dronebo1/lipo-charger-breakout-board/README.md

# lipo-charger-breakout-board
Ever wanted to fully utilize every channel on your 8S/6S lipo charger? Use this board to use every channel at the same time, breaking out up to 8 channels, allowing you to charge 8 1S cells, 2 4S cells, or even one 4S cell with 2 2S cells. It also comes with basic safety features to ensure that you connect cells correctly, USBC PD, and a low voltage monitor to ensure you don't over drain your cells.
