dronebo1/lipo-charger-breakout-board/grantscreenshots/BEC_1.jpg

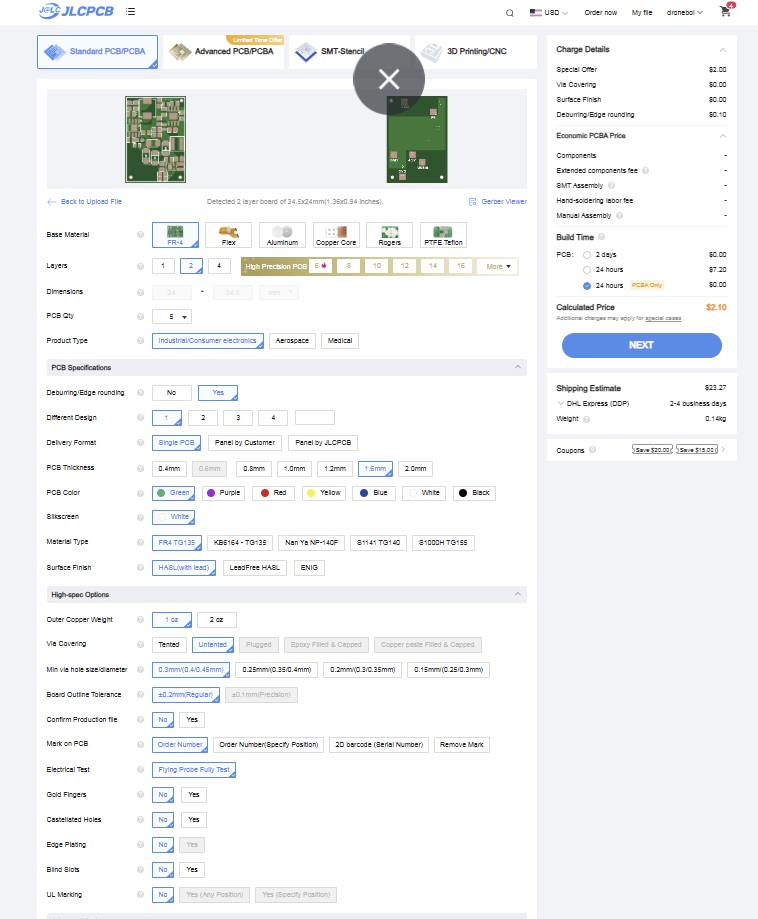
grantscreenshots/BEC_1.jpg
