dronebo1/lipo-charger-breakout-board/grantscreenshots/BEC_2.jpg

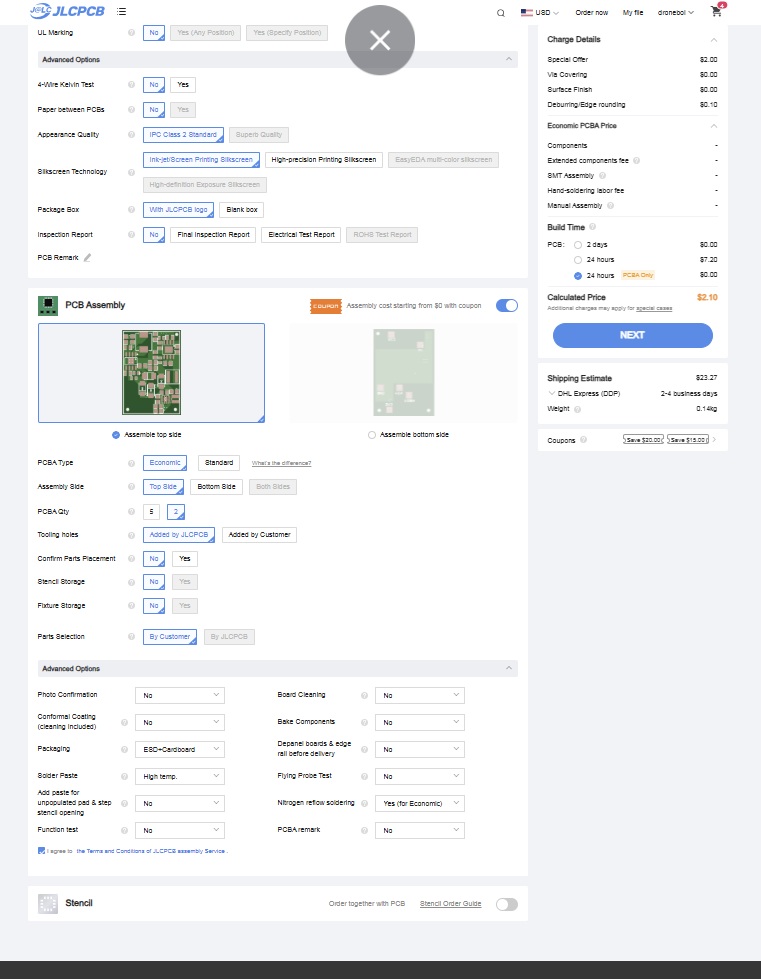
grantscreenshots/BEC_2.jpg
