dronebo1/lipo-charger-breakout-board/grantscreenshots/BEC_3.jpg

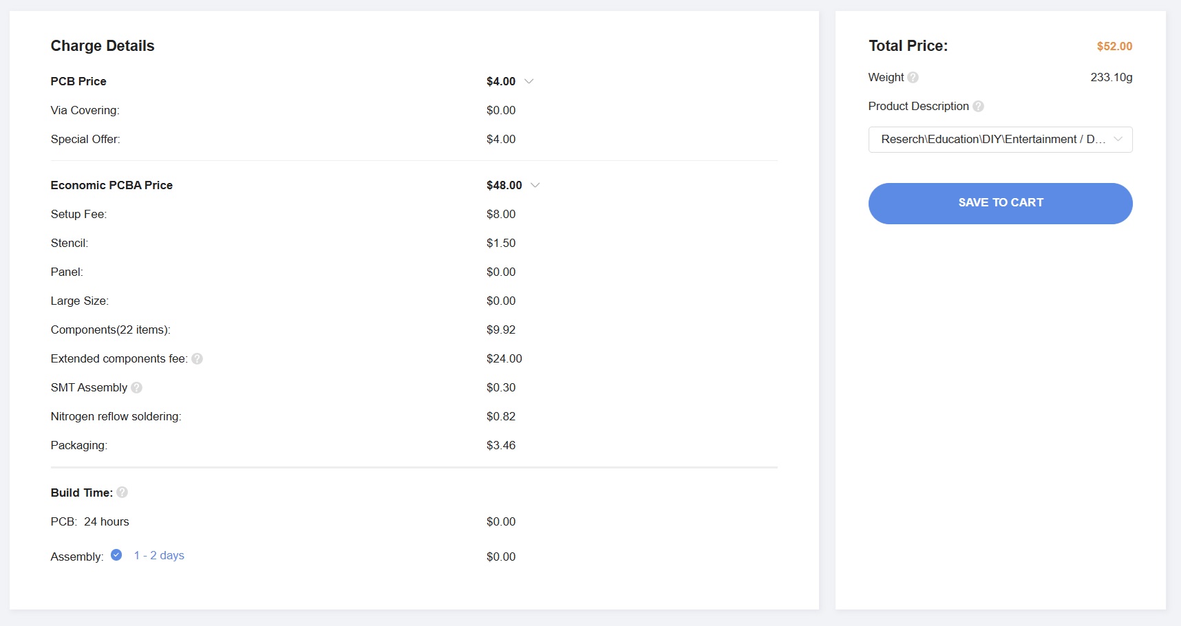
grantscreenshots/BEC_3.jpg
