dronebo1/lipo-charger-breakout-board/grantscreenshots/final_public.jpg

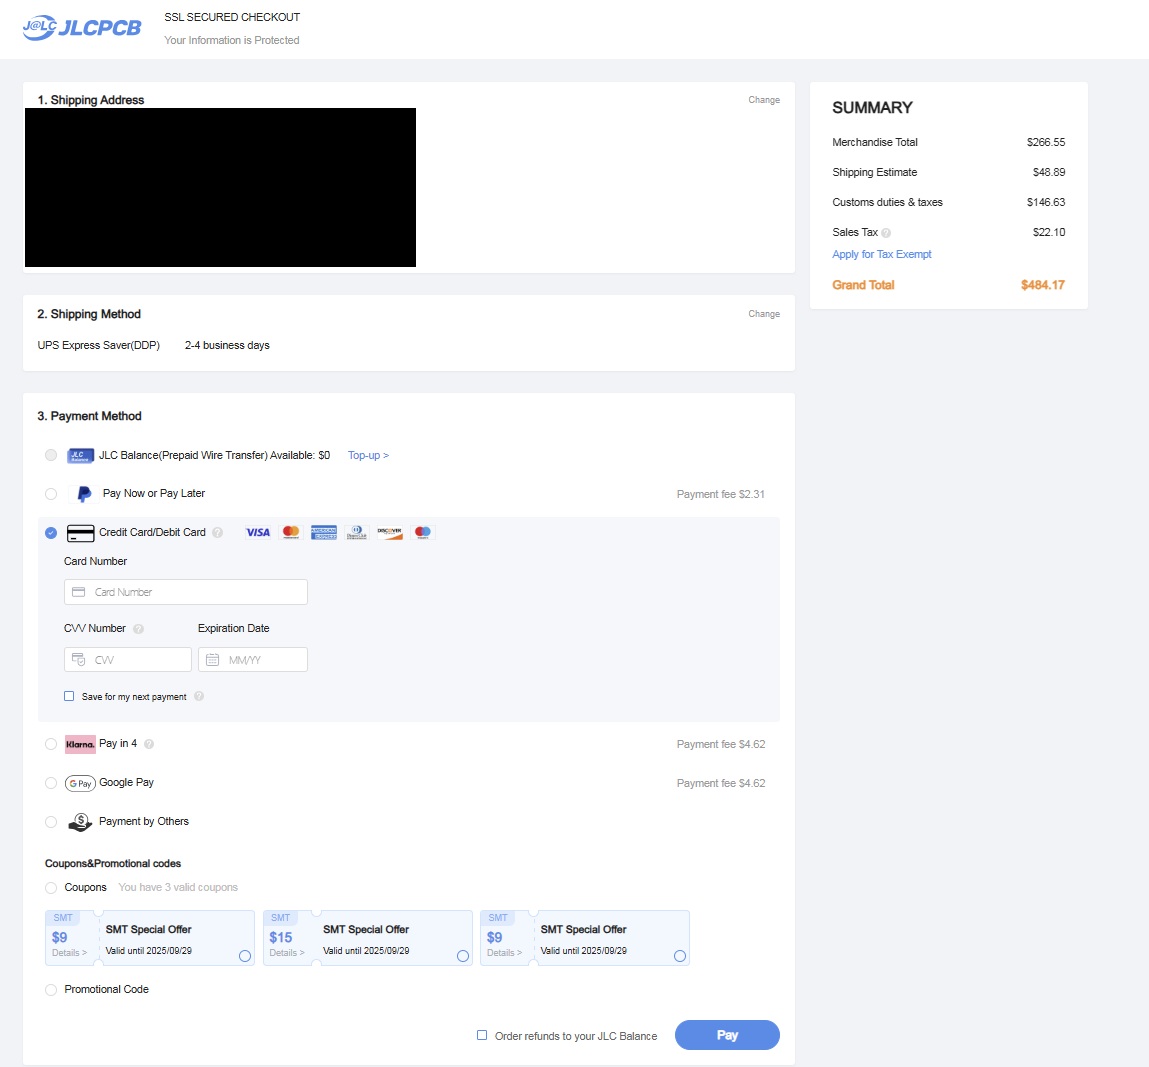
grantscreenshots/final_public.jpg
