dronebo1/lipo-charger-breakout-board/grantscreenshots/mainboard_1.jpg

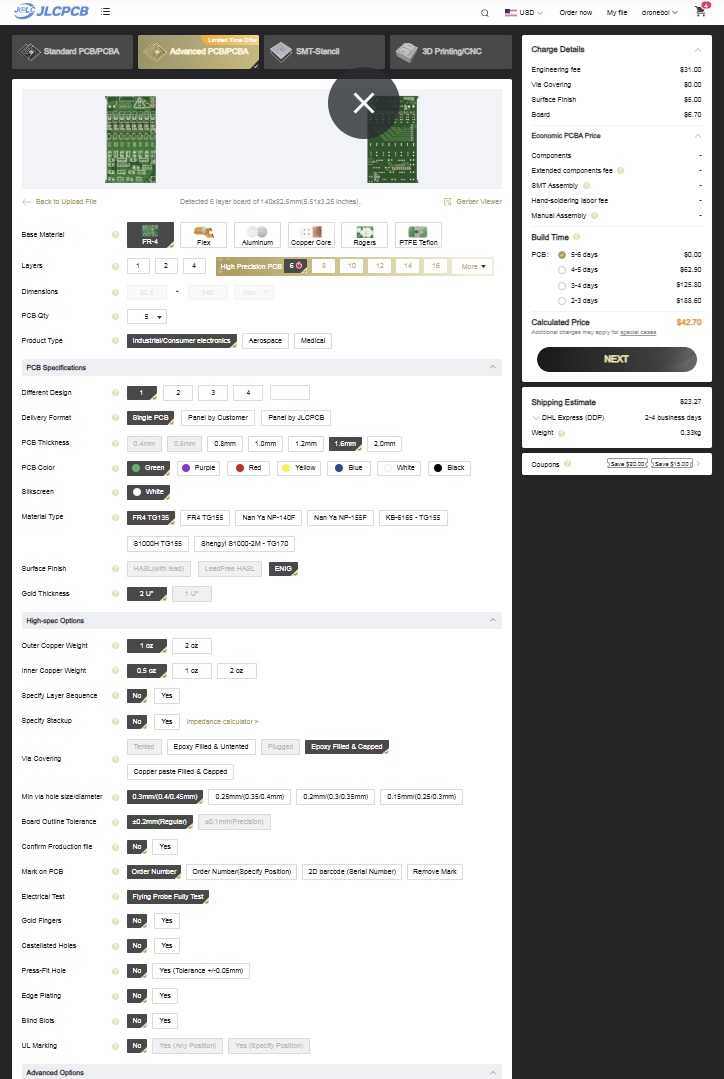
grantscreenshots/mainboard_1.jpg
