dronebo1/lipo-charger-breakout-board/grantscreenshots/mainboard_2.jpg

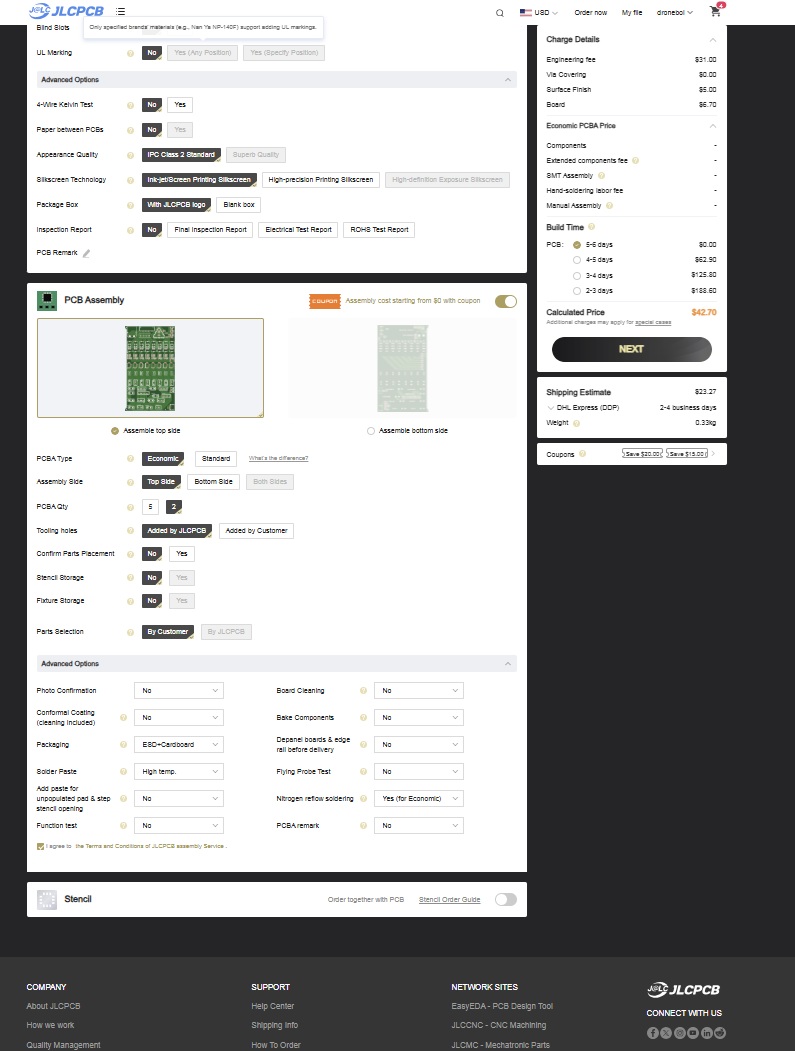
grantscreenshots/mainboard_2.jpg
