dronebo1/lipo-charger-breakout-board/grantscreenshots/overall.jpg

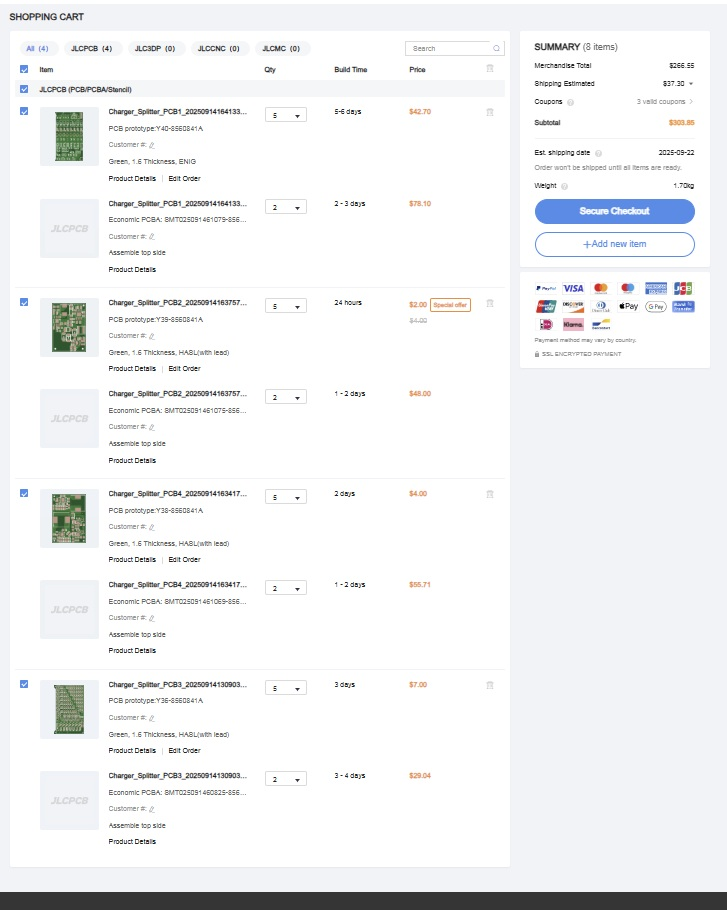
grantscreenshots/overall.jpg
