dronebo1/lipo-charger-breakout-board/grantscreenshots/protector_1.jpg

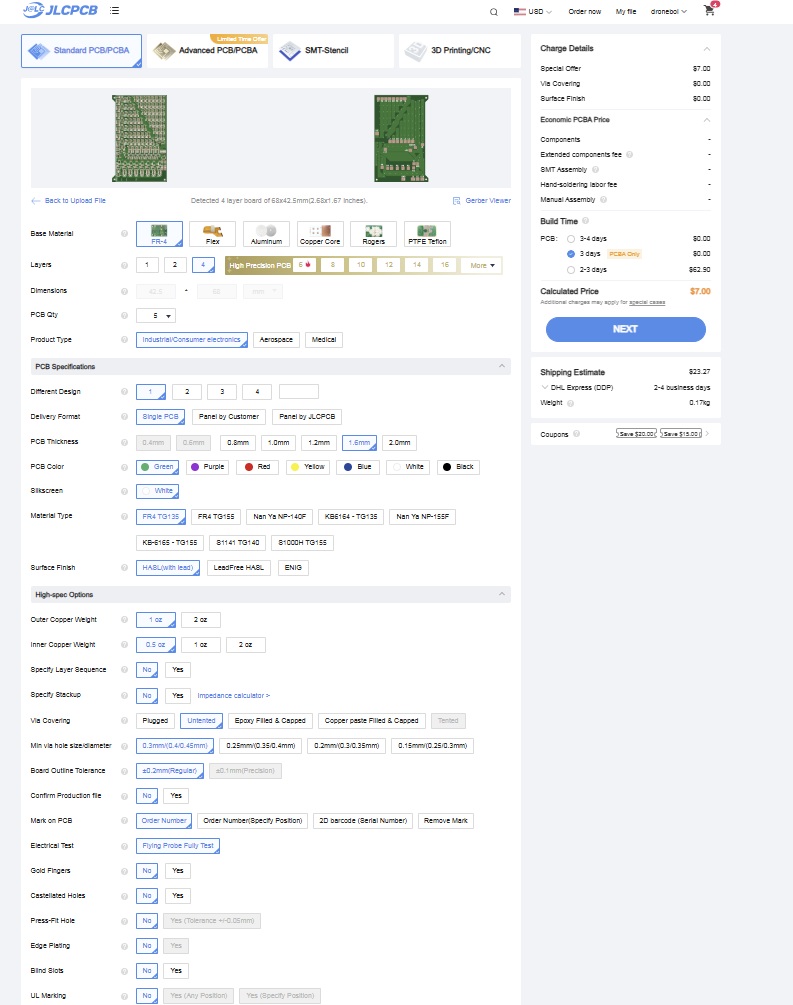
grantscreenshots/protector_1.jpg
