dronebo1/lipo-charger-breakout-board/grantscreenshots/protector_2.jpg

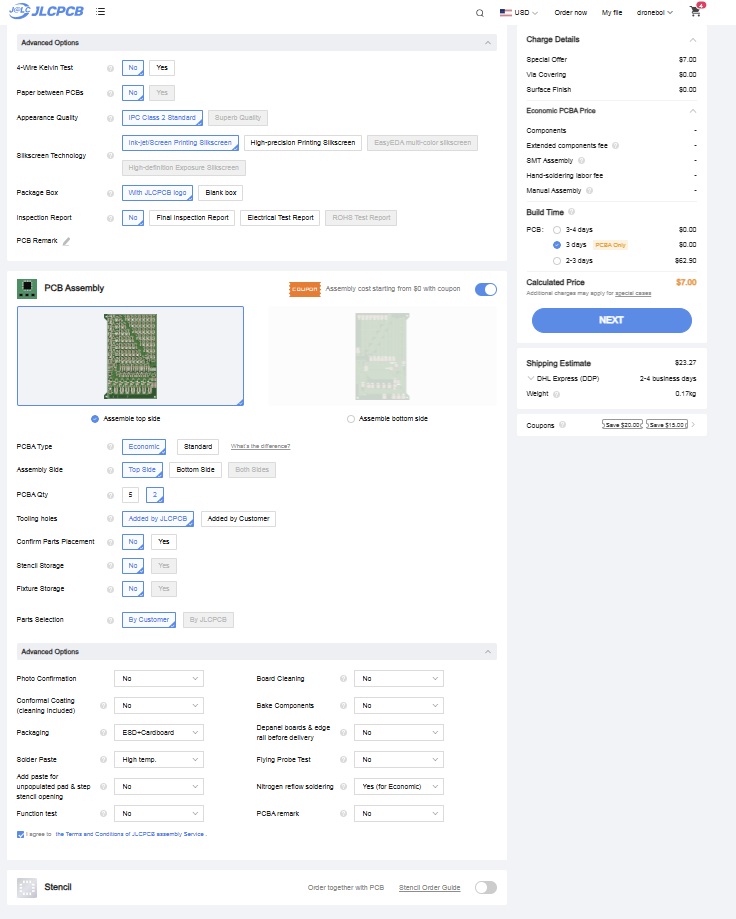
grantscreenshots/protector_2.jpg
