dronebo1/lipo-charger-breakout-board/productionfiles/MAINBOARD_BOM.xlsx

No. | Quantity | Comment | Designator | Footprint | Value | Manufacturer Part | Manufacturer | Supplier Part | Supplier
1 | 8 | PH2.0-2P-LT | 1S1,1S2,1S3,1S4,1S5,1S6,1S7,1S8 | CONN-SMD_PH2.0-1X2PW |  | PH2.0-2P-LT | CAX(创都) | C722761 | LCSC
2 | 12 | XT30UPB-M | 2S1,2S2,2S3,2S4,3S1,3S2,4S1,4S2,6S1,(3S+)2S1,(3S+)2S2,(3S+)4S1 | CONN-TH_XT30UPB-M |  | XT30UPB-M | AMASS(艾迈斯) | C428721 | LCSC
3 | 6 | XH-3A | 2S1B,2S2B,2S3B,2S4B,(3S+)2S1B,(3S+)2S2B | CONN-TH_XH-3A |  | XH-3A | HCTL(华灿天禄) | C2908601 | LCSC
4 | 2 | XH-4A | 3S1B,3S2B1 | CONN-TH_XH2.50-4P |  | XH-4A | HCTL(华灿天禄) | C2908602 | LCSC
5 | 3 | XH-5A | 4S1B,4S2B,(3S+)4S1B | CONN-TH_5P-P2.50_XH-5A |  | XH-5A | HCTL(华灿天禄) | C2908603 | LCSC
6 | 1 | XH-7A | 6S1B | CONN-TH_7P-P2.50_HCTL_XH-7A |  | XH-7A | HCTL(华灿天禄) | C2908605 | LCSC
7 | 8 | NCD0805R1 | CELL1,CELL2,CELL3,CELL4,CELL5,CELL6,CELL7,CELL8 | LED0805-R-RD |  | NCD0805R1 | 国星光电 | C84256 | LCSC
8 | 3 | KT-1206W | CELL,LOWBATT,SWITCH | LED1206-R-RD_WHITE |  | KT-1206W | KENTO | C71796 | LCSC
9 | 12 | AGM6014AP | CELLLEDQ1,CELLLEDQ2,CELLLEDQ3,CELLLEDQ4,CELLLEDQ5,CELLLEDQ6,CELLLEDQ7,CELLLEDQ8,ERRORLEDARRQ1,ERRORLEDQ1,ERRORLEDQ2,ERRORLEDQ3 | PDFN-8_L3.1-W3.0-P0.65-LS3.3-BL |  | AGM6014AP | AGM-Semi(芯控源) | C6719405 | LCSC
10 | 1 | 68Ω | CELLLEDR1 | R2512 | 68Ω | 25121WF680JT4E | UNI-ROYAL(厚声) | C50371 | LCSC
11 | 1 | XH-9AW | CN9 | CONN-TH_9P-P2.50_XH-9AW |  | XH-9AW | BOOMELE(博穆精密) | C44437 | LCSC
12 | 1 | XT60PW-M | CN10 | CONN-TH_XT60PW-M |  | XT60PW-M | AMASS(艾迈斯) | C98732 | LCSC
13 | 12 | XL-2012UPC | ERRORLEDARR1,ERRORLEDARR2,ERRORLEDARR3,ERRORLEDARR4,ERRORLEDARR5,ERRORLEDARR6,ERRORLEDARR7,ERRORLEDARR8,ERRORLEDARR9,ERRORLEDARR10,ERRORLEDARR11,ERRORLEDARR12 | LED0805-RD_PINK |  | XL-2012UPC | XINGLIGHT(成兴光) | C965821 | LCSC
14 | 1 | 30Ω | ERRORLEDARRR1 | R2512 | 30Ω | 25121WF300JT4E | UNI-ROYAL(厚声) | C620878 | LCSC
15 | 1 | 20Ω | ERRORLEDR3 | R1210 | 20Ω | 1210W2F200JT5E | UNI-ROYAL(厚声) | C620667 | LCSC
16 | 1 | XH-7A | P2 | CONN-TH_7P_XH-7A |  | XH-7A | BOOMELE(博穆精密) | C10384 | LCSC
17 | 8 | SS-22F07-G100 | SW1,SW2,SW3,SW4,SW5,SW6,SW7,SW8 | SW-TH_6P-L16.5-W7.5-P4.0-LS2.6-TL |  | SS-22F07-G100 | G-Switch(品赞) | C5446810 | LCSC
18 | 8 | NCD0805Y1 | SW1LED1,SW2LED1,SW3LED1,SW4LED1,SW5LED1,SW6LED1,SW7LED1,SW8LED1 | LED0805-R-RD |  | NCD0805Y1 | 国星光电 | C84261 | LCSC
19 | 8 | 3kΩ | SW1R1,SW2R1,SW3R1,SW4R1,SW5R1,SW6R1,SW7R1,SW8R1 | R0805 | 3kΩ | 0805W8F3001T5E | UNI-ROYAL(厚声) | C17661 | LCSC
20 | 8 | 68Ω | SW1R2,SW2R2,SW3R2,SW4R2,SW5R2,SW6R2,SW7R2,SW8R2 | R0805 | 68Ω | RC0805FR-0768RL | YAGEO(国巨) | C137498 | LCSC
21 | 1 | KH-TYPE-C-6P | USB-IN | TYPE-C-SMD_TYPE-C-31-M-16 |  | KH-TYPE-C-6P | kinghelm(金航标) | C709355 | LCSC
22 | 1 | TYPE-C-31-M-12 | USB-OUT | USB-C_SMD-TYPE-C-31-M-12 |  | TYPE-C-31-M-12 | 韩国韩荣 | C165948 | LCSC
