dronebo1/lipo-charger-breakout-board/productionfiles/USBPD_BOM.xlsx

No. | Quantity | Comment | Designator | Footprint | Value | Manufacturer Part | Manufacturer | Supplier Part | Supplier
1 | 2 | 100nF | BUCKC1,PDC1 | C0805 | 100nF | CC0805KRX7R9BB104 | YAGEO(国巨) | C49678 | LCSC
2 | 13 | 10uF | BUCKC2,BUCKC3,BUCKC4,BUCKC5,BUCKC6,PDC3,PDC4,PDC5,PDC6,PDC7,PDC8,PDC9,PDC12 | C0805 | 10uF | GRM21BR61H106KE43L | muRata(村田) | C440198 | LCSC
3 | 1 | RSX501L-20TE25 | BUCKD1 | SMA_L4.5-W2.6-LS5.0-RD |  | RSX501L-20TE25 | ROHM(罗姆) | C329921 | LCSC
4 | 1 | 15uH | BUCKL1 | IND-SMD_L13.7-W12.6_MS1360 | 15uH | FCH1365-150M | FC(方成) | C20415554 | LCSC
5 | 1 | 270kΩ | BUCKR1 | R0805 | 270kΩ | 0805W8F2703T5E | UNI-ROYAL(厚声) | C17589 | LCSC
6 | 2 | 13kΩ | BUCKR2,BUCKR6 | R0805 | 13kΩ | 0805W8F1302T5E | UNI-ROYAL(厚声) | C17455 | LCSC
7 | 1 | 200kΩ | BUCKR3 | R0805 | 200kΩ | 0805W8F2003T5E | UNI-ROYAL(厚声) | C17539 | LCSC
8 | 1 | 75kΩ | BUCKR4 | R0603 | 75kΩ | 0603WAF7502T5E | UNI-ROYAL(厚声) | C23242 | LCSC
9 | 2 | 3kΩ | BUCKR5,BUCKR7 | R0805 | 3kΩ | 0805W8F3001T5E | UNI-ROYAL(厚声) | C17661 | LCSC
10 | 1 | 10nF | C22 | C0805 | 10nF | CL21B103KBANNNC | SAMSUNG(三星) | C1710 | LCSC
11 | 2 | 47uF | C23,C24 | C0805 | 47uF | CL21A476MQYNNNE | SAMSUNG(三星) | C16780 | LCSC
12 | 2 | SP40P18NJ | HIGHQ1,LOWQ1 | DFN-8_L3.0-W3.0-P0.65-BL-EP_PE5G6EA |  | SP40P18NJ | Siliup(矽普) | C41355197 | LCSC
13 | 2 | AGM6014AP | HIGHQ2,LOWQ2 | PDFN-8_L3.1-W3.0-P0.65-LS3.3-BL |  | AGM6014AP | AGM-Semi(芯控源) | C6719405 | LCSC
14 | 2 | 2kΩ | HIGHR1,LOWR1 | R0805 | 2kΩ | 0805W8F2001T5E | UNI-ROYAL(厚声) | C17604 | LCSC
15 | 4 | 1kΩ | HIGHR2,HIGHR3,LOWR2,LOWR3 | R0805 | 1kΩ | 0805W8F1001T5E | UNI-ROYAL(厚声) | C17513 | LCSC
16 | 2 | EG27517 | HIGHU1,LOWU1 | SOT-23-5_L2.9-W1.6-P0.95-LS2.8-BR |  | EG27517 | EG(屹晶微) | C2987449 | LCSC
17 | 1 | AP64352SP-13 | PDBUCK1 | SO-8_L4.9-W3.9-P1.27-LS6.0-BL-EP |  | AP64352SP-13 | DIODES(美台) | C2071665 | LCSC
18 | 1 | 220uF | PDC2 | C1206 | 220uF | GRM31CR60J227ME11L | muRata(村田) | C412252 | LCSC
19 | 1 | 33uH | PDL1 | IND-SMD_L13.5-W12.5 | 33uH | TMPC1265HP-330MG-D | TAI-TECH(台庆) | C2880059 | LCSC
20 | 1 | 10kΩ | PDR1 | R0805 | 10kΩ | 0805W8F1002T5E | UNI-ROYAL(厚声) | C17414 | LCSC
21 | 2 | 2Ω | R1,R2 | R0603 | 2Ω | 0603WAF200KT5E | UNI-ROYAL(厚声) | C22977 | LCSC
22 | 1 | XPM52CDP65 | USBPDREG1 | QFN-16_L4.0-W4.0-P0.65-TL-EP2.3 |  | XPM52CDP65 | FM(富满) | C42460907 | LCSC
