dronebo1/lipo-charger-breakout-board/productionfiles/BEC_BOM.xlsx

No. | Quantity | Comment | Designator | Footprint | Value | Manufacturer Part | Manufacturer | Supplier Part | Supplier
1 | 1 | TPS63001DRCR | 3V3BUCKBOOST1 | VSON-10_L3.0-W3.0-P0.50-TL-EP_TPS62410DRCR |  | TPS63001DRCR | TI(德州仪器) | C28060 | LCSC
2 | 3 | 10uF | 3V3C1,3V3C3,3V3C4 | C0805 | 10uF | CL21A106KAYNNNE | SAMSUNG(三星) | C15850 | LCSC
3 | 2 | 100nF | 3V3C2,5VC1 | C0805 | 100nF | CC0805KRX7R9BB104 | YAGEO(国巨) | C49678 | LCSC
4 | 1 | 2.2uH | 3V3L1 | IND-SMD_L3.0-W3.0_NR3010 | 2.2uH | NR3015T2R2M | TAIYO YUDEN(太诱) | C86423 | LCSC
5 | 1 | 100Ω | 3V3R1 | R0805 | 100Ω | 0805W8F1000T5E | UNI-ROYAL(厚声) | C17408 | LCSC
6 | 4 | 22uF | 5VBC1,5VBC5,5VC3,5VC4 | C0805 | 22uF | CL21A226MAQNNNE | SAMSUNG(三星) | C45783 | LCSC
7 | 1 | 1nF | 5VBC2 | C0805 | 1nF | CL21B102KBCNNNC | SAMSUNG(三星) | C46653 | LCSC
8 | 1 | 100uF | 5VBC4 | CAP-SMD_L3.5-W2.8-R-RD | 100uF | CA45A-B-10V-100UF-K | CEC(振华新云) | C2976906 | LCSC
9 | 3 | RSX501L-20TE25 | 5VBD1,5VD1,USB-IND1 | SMA_L4.5-W2.6-LS5.0-RD |  | RSX501L-20TE25 | ROHM(罗姆) | C329921 | LCSC
10 | 1 | 3.3uH | 5VBL1 | IND-SMD_L7.0-W6.6 | 3.3uH | FXL0630-3R3-M | cjiang(长江微电) | C167219 | LCSC
11 | 1 | FP6276BXR-G1 | 5VBOOST1 | SOP-8_L4.9-W3.9-P1.27-LS6.0-BL-EP |  | FP6276BXR-G1 | Advanced Analog Technology(类比) | C82652 | LCSC
12 | 2 | 10kΩ | 5VBR1,5VBR3 | R0805 | 10kΩ | 0805W8F1002T5E | UNI-ROYAL(厚声) | C17414 | LCSC
13 | 1 | 75kΩ | 5VBR2 | R0603 | 75kΩ | 0603WAF7502T5E | UNI-ROYAL(厚声) | C23242 | LCSC
14 | 2 | 39kΩ | 5VBR4,5VR2 | R0603 | 39kΩ | 0603WAF3902T5E | UNI-ROYAL(厚声) | C23153 | LCSC
15 | 1 | AP64352SP-13 | 5VBUCK1 | SO-8_L4.9-W3.9-P1.27-LS6.0-BL-EP |  | AP64352SP-13 | DIODES(美台) | C2071665 | LCSC
16 | 1 | 10nF | 5VC2 | C0805 | 10nF | CL21B103KBANNNC | SAMSUNG(三星) | C1710 | LCSC
17 | 1 | 10uF | 5VCx | C0805 | 10uF | GRM21BR61H106KE43L | muRata(村田) | C440198 | LCSC
18 | 1 | 5.6uH | 5VL1 | IND-SMD_L5.5-W5.3 | 5.6uH | FEXL0550A-5R6M | cjiang(长江微电) | C5378514 | LCSC
19 | 1 | 150kΩ | 5VR1 | R0805 | 150kΩ | 0805W8F1503T5E | UNI-ROYAL(厚声) | C17470 | LCSC
20 | 1 | 200kΩ | 5VR3 | R0805 | 200kΩ | 0805W8F2003T5E | UNI-ROYAL(厚声) | C17539 | LCSC
21 | 1 | 120kΩ | 5VR4 | R0603 | 120kΩ | 0603WAF1203T5E | UNI-ROYAL(厚声) | C25808 | LCSC
22 | 1 | 20kΩ | 5VR5 | R0805 | 20kΩ | 0805W8F2002T5E | UNI-ROYAL(厚声) | C4328 | LCSC
