dronebo1/lipo-charger-breakout-board/productionfiles/LogicBOARD_BOM.xlsx

No. | Quantity | Comment | Designator | Footprint | Value | Manufacturer Part | Manufacturer | Supplier Part | Supplier
1 | 3 | 47uF | C1,C2,C3 | C0805 | 47uF | CL21A476MQYNNNE | SAMSUNG(三星) | C16780 | LCSC
2 | 8 | MM1Z3V3 | D22,D36,D38,D40,D42,D44,D46,D48 | SOD-123_L2.7-W1.6-LS3.7-RD |  | MM1Z3V3 | 宏嘉诚 | C22379456 | LCSC
3 | 18 | SD103AWS | D23,D24,D25,D26,D27,D28,D29,D30,D37,D39,D41,D43,D45,D47,D49,D50,D51,D52 | SOD-323_L1.7-W1.3-LS2.6-RD-1 |  | SD103AWS | 宏迦橙 | C7420360 | LCSC
4 | 72 | MMBT4401 | Q164,Q165,Q166,Q167,Q168,Q169,Q170,Q171,Q172,Q173,Q174,Q175,Q176,Q177,Q178,Q179,Q180,Q181,Q182,Q183,Q184,Q185,Q186,Q187,Q188,Q189,Q190,Q191,Q192,Q193,Q194,Q195,Q196,Q197,Q198,Q199,Q200,Q201,Q202,Q203,Q204,Q205,Q206,Q207,Q208,Q209,Q210,Q211,Q212,Q213,Q214,Q215,Q216,Q217,Q218,Q219,Q220,Q221,Q222,Q223,Q224,Q225,Q226,Q227,Q228,Q229,Q230,Q231,Q232,Q233,Q234,Q235 | SOT-23-3_L2.9-W1.3-P1.90-LS2.4-BR |  | MMBT4401 | R+O(宏嘉诚) | C7420355 | LCSC
5 | 24 | MMBT4403 | Q237,Q238,Q239,Q240,Q241,Q242,Q243,Q244,Q245,Q246,Q247,Q248,Q249,Q250,Q251,Q252,Q253,Q254,Q255,Q256,Q257,Q258,Q259,Q260 | SOT-23-3_L2.9-W1.3-P0.95-LS2.4-BR |  | MMBT4403 | R+O(宏嘉诚) | C20069140 | LCSC
6 | 54 | 22kΩ | R81,R82,R83,R87,R88,R89,R90,R91,R92,R93,R94,R95,R96,R97,R98,R99,R100,R101,R102,R103,R104,R105,R106,R107,R108,R109,R110,R111,R112,R113,R114,R115,R116,R117,R118,R119,R120,R121,R122,R123,R124,R125,R126,R127,R128,R129,R130,R131,R132,R190,R217,R219,R222,R223 | R0603 | 22kΩ | 0603WAF2202T5E | UNI-ROYAL(厚声) | C31850 | LCSC
7 | 24 | 3kΩ | R171,R172,R174,R177,R180,R183,R186,R189,R193,R194,R196,R199,R202,R205,R208,R211,R267,R268,R269,R270,R271,R272,R273,R274 | R0603 | 3kΩ | 0603WAF3001T5E | UNI-ROYAL(厚声) | C4211 | LCSC
8 | 2 | 6.2kΩ | R175,R212 | R0603 | 6.2kΩ | 0603WAF6201T5E | UNI-ROYAL(厚声) | C4260 | LCSC
9 | 9 | 9.1kΩ | R178,R213,R260,R261,R262,R263,R264,R266,R275 | R0603 | 9.1kΩ | 0603WAF9101T5E | UNI-ROYAL(厚声) | C23260 | LCSC
10 | 38 | 12kΩ | R181,R214,R224,R225,R226,R227,R228,R229,R230,R231,R232,R233,R234,R235,R236,R237,R238,R239,R240,R241,R242,R243,R244,R245,R246,R247,R248,R249,R250,R251,R252,R253,R254,R255,R256,R257,R258,R259 | R0603 | 12kΩ | 0603WAF1202T5E | UNI-ROYAL(厚声) | C22790 | LCSC
11 | 2 | 15kΩ | R184,R215 | R0603 | 15kΩ | 0603WAF1502T5E | UNI-ROYAL(厚声) | C22809 | LCSC
12 | 2 | 18kΩ | R187,R216 | R0603 | 18kΩ | 0603WAF1802T5E | UNI-ROYAL(厚声) | C25810 | LCSC
13 | 12 | EG27517 | U12,U13,U14,U15,U16,U17,U18,U19,U20,U21,U22,U24 | SOT-23-5_L2.9-W1.6-P0.95-LS2.8-BR |  | EG27517 | EG(屹晶微) | C2987449 | LCSC
