dronebo1/lipo-charger-breakout-board/JOURNAL.md

Title: Lipo charger breakout board

Author: Droneboi

Description: Ever wanted to fully utilize every channel on your 8S/6S lipo charger? Use this board to use every channel at the same time, breaking out up to 8 channels, allowing you to charge 8 1S cells, 2 4S cells, or even one 4S cell with 2 2S cells. It also comes with basic safety features to ensure that you connect cells correctly, USBC PD, and a low voltage monitor to ensure you don't over drain your cells.

Created On: 8/9/2025

# Aug 9th: Put together basic structure of ports, as well as general schematic and functions

Allows for all cell configurations under 8S, excluding the use of 5S lipos, as those are highly uncommon. Also included switches to control the total cell voltage for linking the correct balence pin to the VCC pin on the XT60 port of the charger, as well as indicator LEDs to minimize chance of accidental shorts. 
Also added a buck boost module as a regulator to provide a stable voltage for the LEDs, which can either source from the 1S port, or the USBC in port.



**Total time spent: 7h**

# Aug 10th: Organized schmatic, looking for parts

Looking through jlc parts library for BJT and USB PD source controller.
Also brainstorming how to configure BJT logic for anti-short warning and prevention



**Total time spent: 4h**

# Aug 17-18th: DESIGN DESIGN DESIGN

Decided to split boards between bjt logic and interface. Working on interface. Did a LOT of design and part selection (yes I more or less did this in one sitting and no I wasn't being lazy about previous work, this is my first time working on it in a while). I've added LED indicators, reduced some part counts by using one big resistor instead of a few small ones, changed out connectors I decided to use, and added USB connectors for USBPD out. I think that covers most of it. ALthough this log might be a lil off, given that I'm writing this at 2:01 AM local time.



**Total time spent: 13h**

# Aug 19-20: Finishing up (Schematic) !!!

Finally finished configuring the control scheme for the input on the USBPD chip so that it can operate both within the spec inside the normal PD chip range, but also has another buck converter that it will switch the input to on its own when the input voltage exceeds the range of the PD chip, allowing it to work efficentially under both conditions



**Total time spent: 7h**

# Aug 20-25: Major updates

Redid schematic to split the design into multiple boards to optimize space and keep the board reasonably small, started laying out the PCB, gonna start routing soon.



**Total time spent: 6h**

# Sept 2: Grounded got an extension I have been saved :O

So I thought the Grounded event from hackclub was gonna end on Aug 31 so there was a lot of panic and cram but turns out it was extended. I've routed the primary board and began laying out components on the power regulation boards while I also try to figure out the logic for the safety functions through some BJTs. Also trying to find space on the back of the board to solder on the additional boards. I've also decided to make the primary board a 6 layer board with 0.5 oz inner copper weight instead of a 4 layer board with 1 oz inner copper weight as it is cheaper, and I just duplicated the inner layers.






**Total time spent: 17h**

# Sept 3-4: Working out the protection logic board

Now working on the board (that solders onto the main board) that uses BJT logic to do things like low voltage protection, ensuring battery cells are connected properly, and checking that no more then one cell is connected to VCC (only the highest cell should be connected to the VCC line)



**Total time spent: 6h**

# Sept 4-5: Finished protection logic board schematic

Schematic is done! See below for pics:




**Total time spent: 4.5h**

# Sept 5: Nevermind, the schematic isn't done

I decided to change a few things. Namely: Switching the MMBT4401 BJT model to one that has no loading fee with JLC to save $3. I also increased some of the resistor values to reduce the logic power draw/power going to waste. I also swaped out the MMBT4403 BJTs for ones that were promotional extended as well, saving another $3. 




**Total time spent: 1.5h**

# Sept 5-6: (Layout) I told myself I would finish it up quickly. I did not.

So I decided that I hate my mental health and decided at 12:30 AM that I would grind this out until the layout was **entirely** finished, but little would I know I would still be working on it past 2:00 AM. Anyhow, the layout is now done for the protection logic board.



**Total time spent: 5h**

# Sept 7: A lot of routing

Got through routing the other three boards, although I'm most behind on the logic board, for olvious reasons.





**Total time spent: 10.5h**

# Sept 9: Finishing protection logic board routing

The sept 20th deadline is creeping closer... so I'm trying to finish soon. Hopefully. So I grinded out all of the rest of the routing for the protection logic PCB, which was a little harder then I thought, as there was many intersecting ratlines.




**Total time spent: 4h**

# Sept 10: Finalizing

Finishing things up:

Adding pads to the back of the logic protection board 

Adding tooling holes to the main board and modifying outline to accommodate for holes




**Total time spent: 3h**

# Sept 11: Final stretch!

Added pads to the back of the main board for wiring to other boards

Added pads to other two power converter boards also for wiring

Also added tooling holes for all boards, and finialized everything

Also now trying to export everything and throw it into JLC so I can see how much it costs... scary...





**Total time spent: 5**

# Sept 12: JLC doesn't have parts I need T-T

I stupidly design the high side switch oof the USBPD module (to turn it on an off) with a pretty specific chip with new features, but it went out of stock by the time I actually finished everything, so I spent basically the entire day looking for alturnatives until I stupidly realized that I can just connect a P channel MOSFET driven low by a N channel MOSFET with a pullup resistor on the gate



**Total time spent: 7h**

# Sept 14: Finishing up (for real this time)

Finalizing the board, routing new design with schmatic changes, looking for any JLC extended parts that I can replace with basic parts to save money and adding some capacitors for filtering. Going through all the resistors and capacitors that I have and recalculating what possible options work with the ICs so that I can use basic ones takes a *ton* of time.



BEC: ($71 before optimization :O )



USBPD chip: ($78 before optimization)



**Total time spent: 10h**

Final costs:
