dronebo1/lipo-charger-breakout-board/productionfiles/BEC_Schematic.pdf

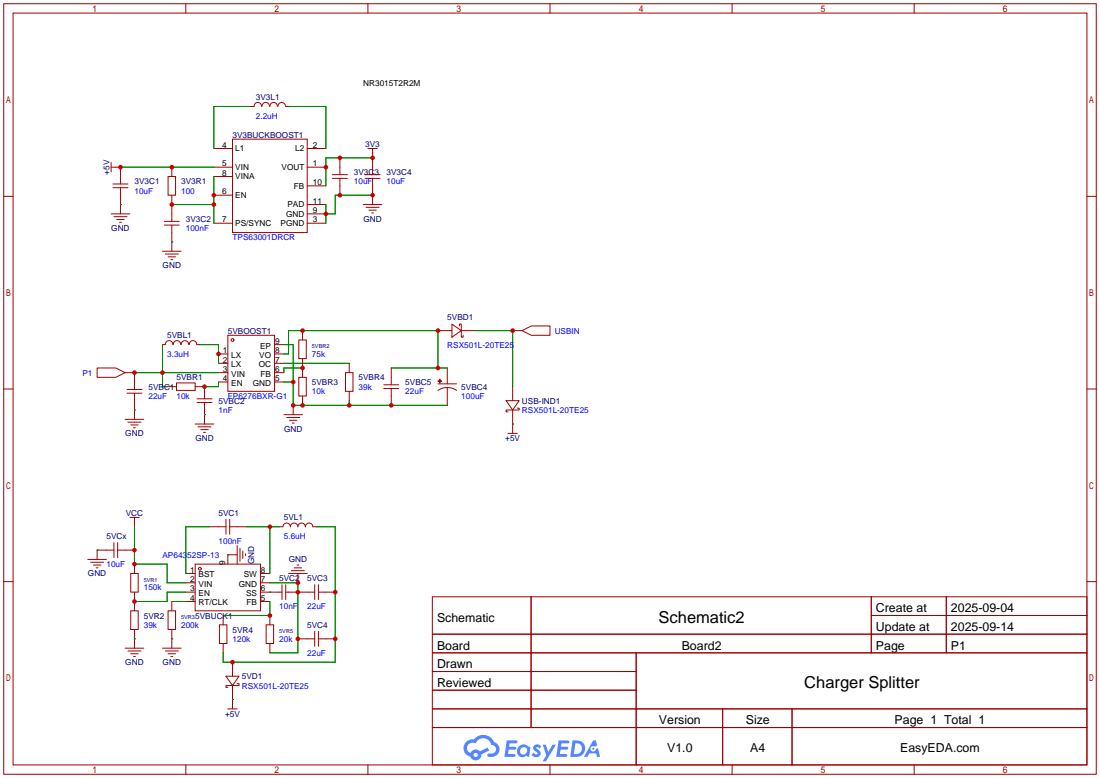
[picture p10: page 1]

Schematic | Schematic2 | Create at | 2025-09-04

Update at | 2025-09-14

Board | Board2 | Page | P1
Drawn | | Charger Splitter
Reviewed

Version | Size | Page 1 Total 1
V1.0 | A4 | EasyEDA.com
