dronebo1/lipo-charger-breakout-board/productionfiles/LogicBOARD_SchematicP1.pdf

# LEDMOS4 LEDMOS⁷

# LEDMOS4 LEDMOS⁸

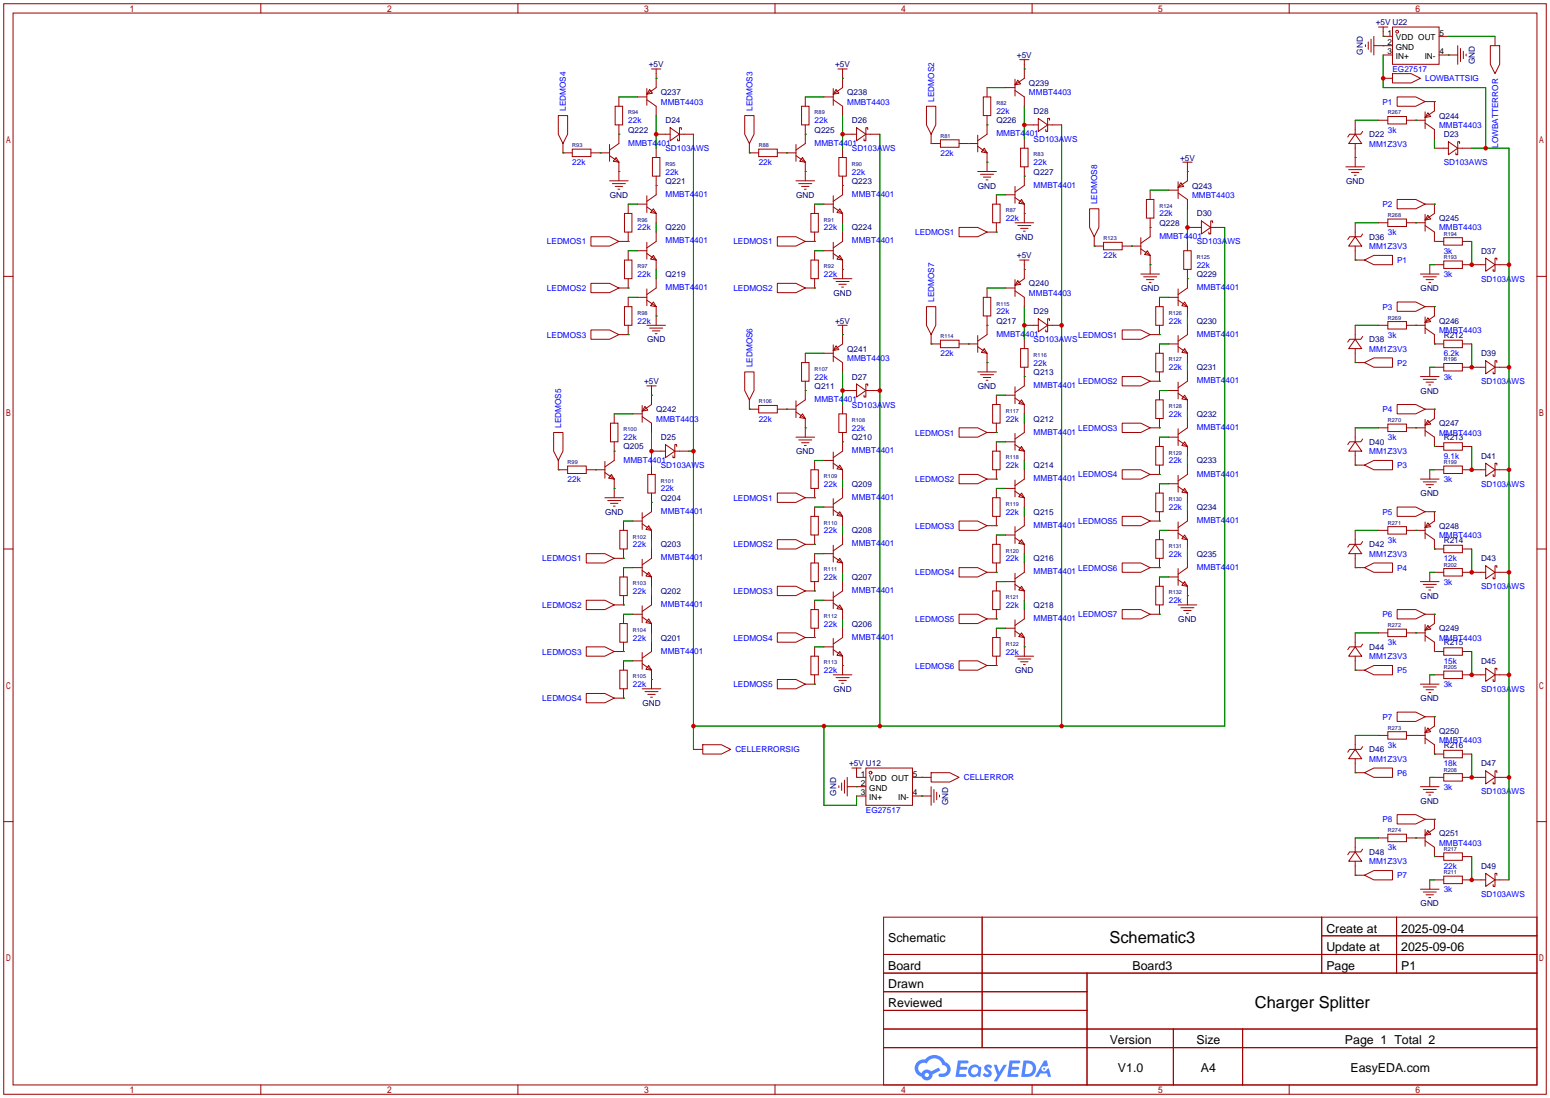
[picture p11: page 1]

Schematic | Schematic3 | Create at | 2025-09-04

Update at | 2025-09-06

Board | Board3 | Page | P1
Drawn | | Charger Splitter
Reviewed

Version | Size | Page 1 Total 2
V1.0 | A4 | EasyEDA.com

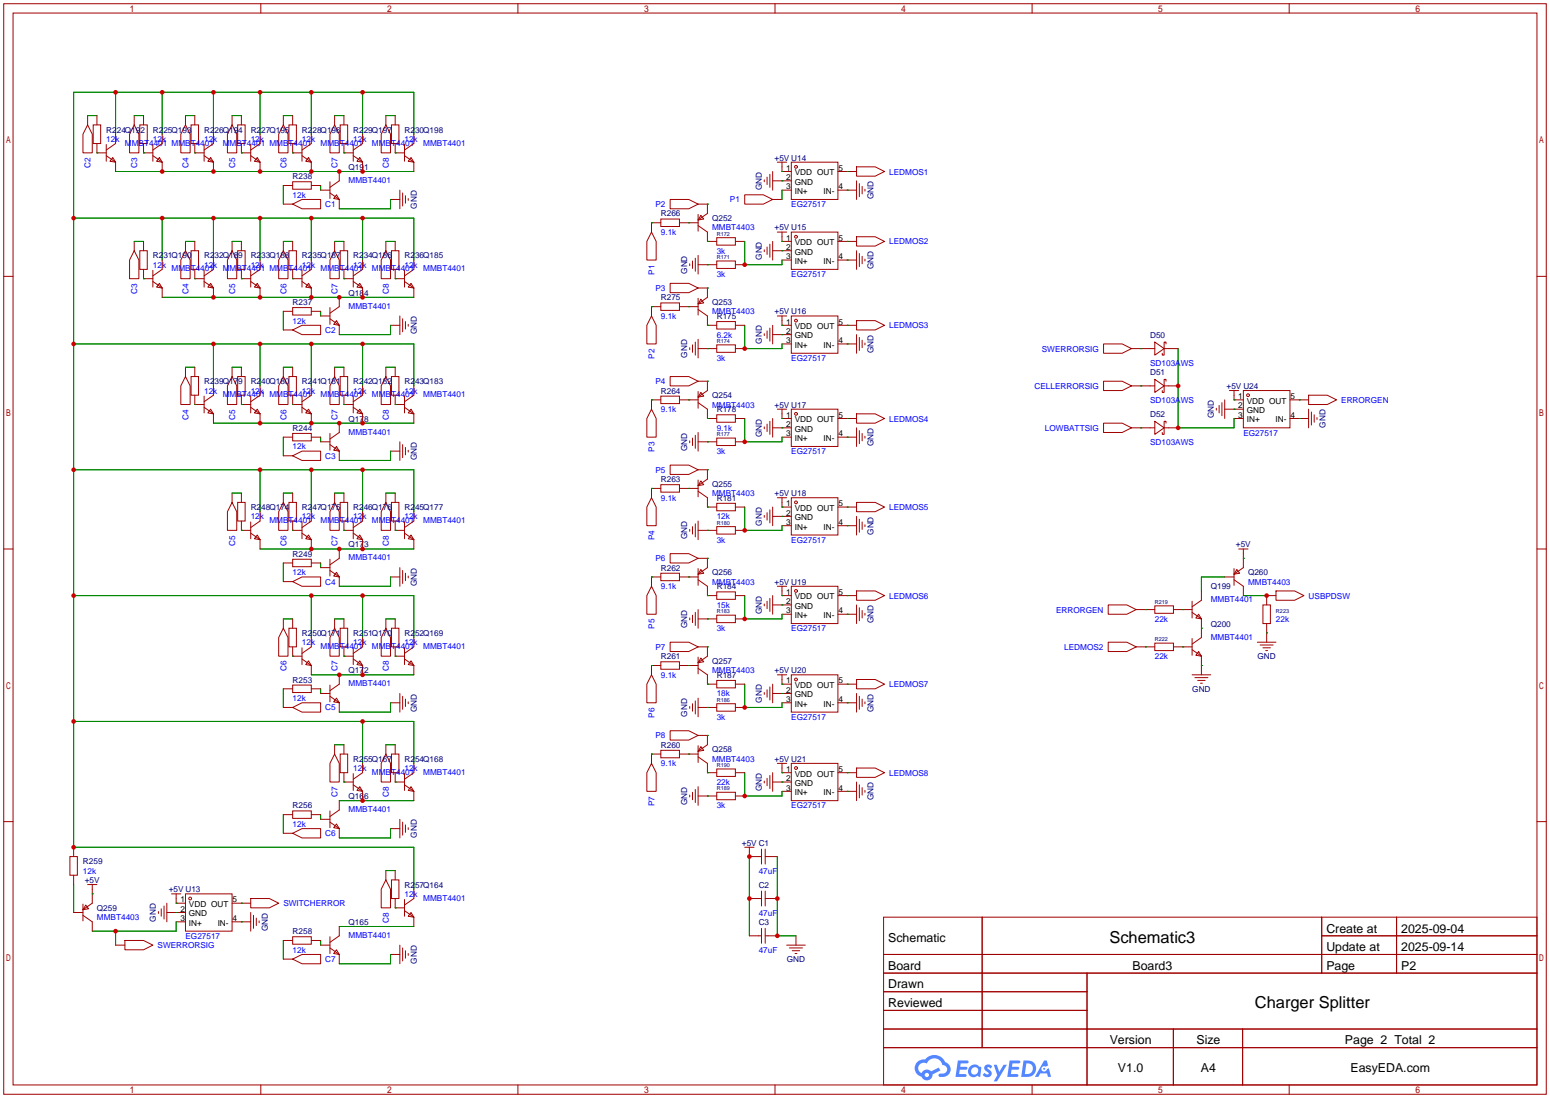
[picture p12: page 2]

Schematic | Schematic3 | Create at | 2025-09-04

Update at | 2025-09-14

Board | Board3 | Page | P2
Drawn | | Charger Splitter
Reviewed

Version | Size | Page 2 Total 2
V1.0 | A4 | EasyEDA.com
