dronebo1/lipo-charger-breakout-board/productionfiles/MAINBOARD_Schematic.pdf

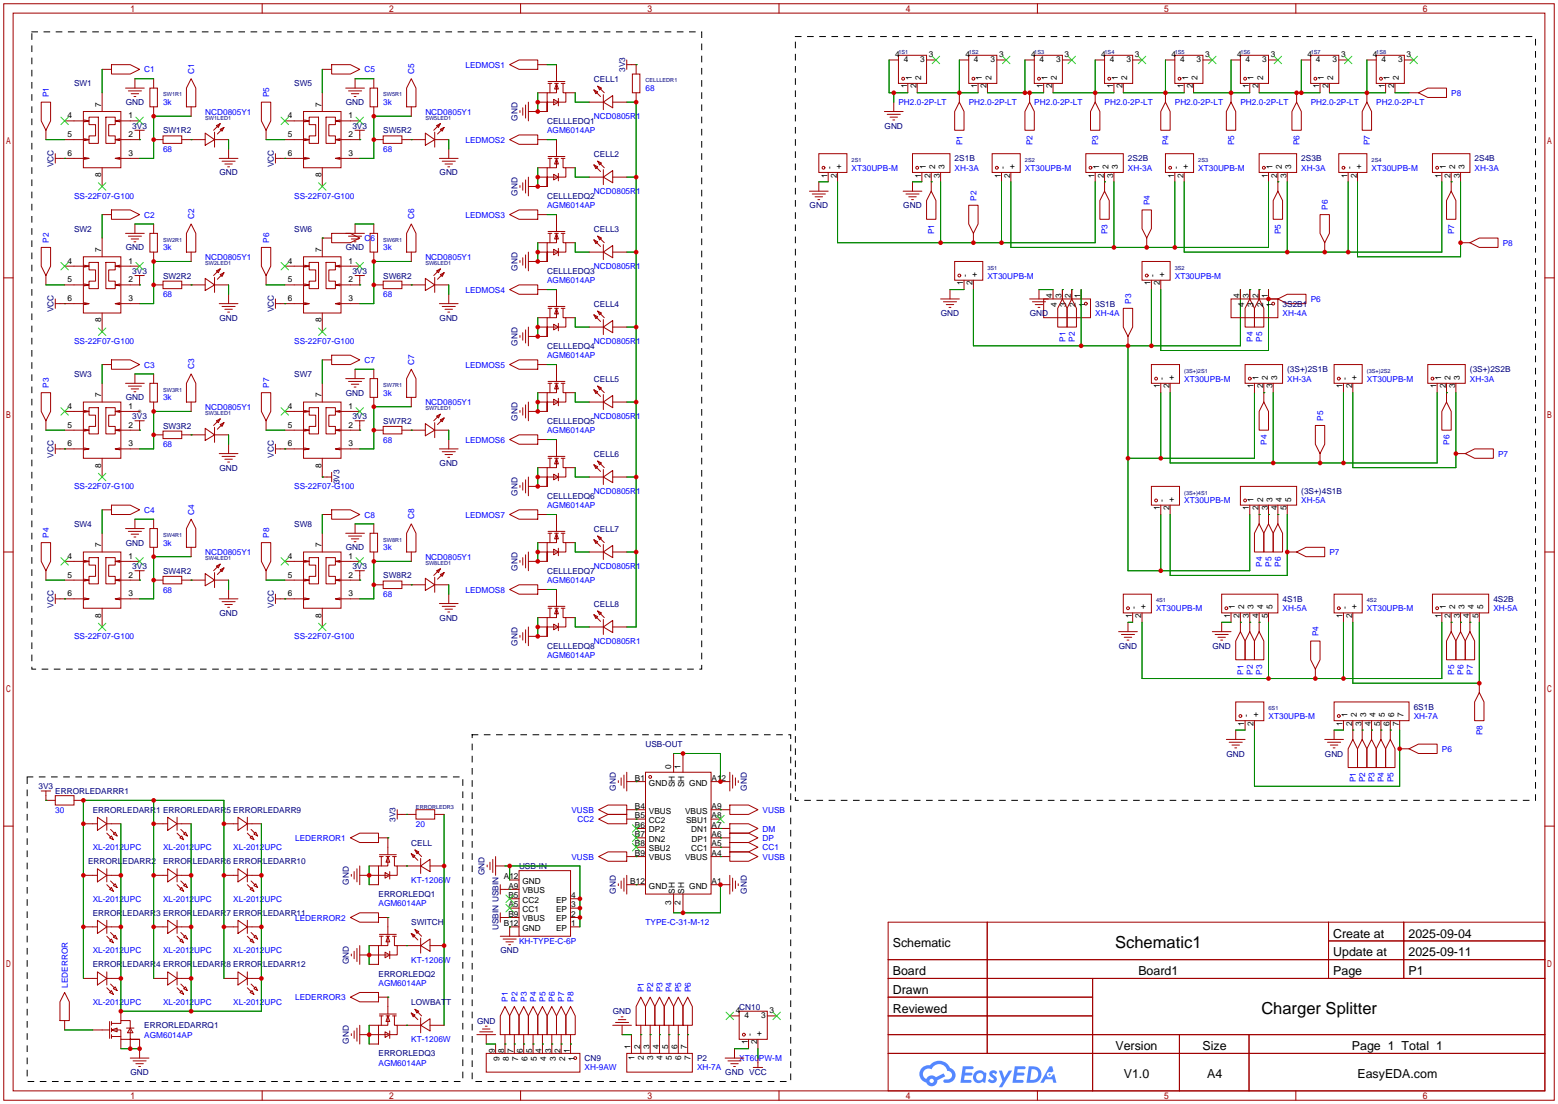
[picture p13: page 1]

VCC VCC

Schematic | Schematic1 | Create at | 2025-09-04

Update at | 2025-09-11

Board | Board1 | Page | P1
Drawn | | Charger Splitter
Reviewed

Version | Size | Page 1 Total 1

V1.0 | A4 | EasyEDA.com
