dronebo1/lipo-charger-breakout-board/productionfiles/USBPD_Schematic.pdf

# RSX501L-20TE25 GND

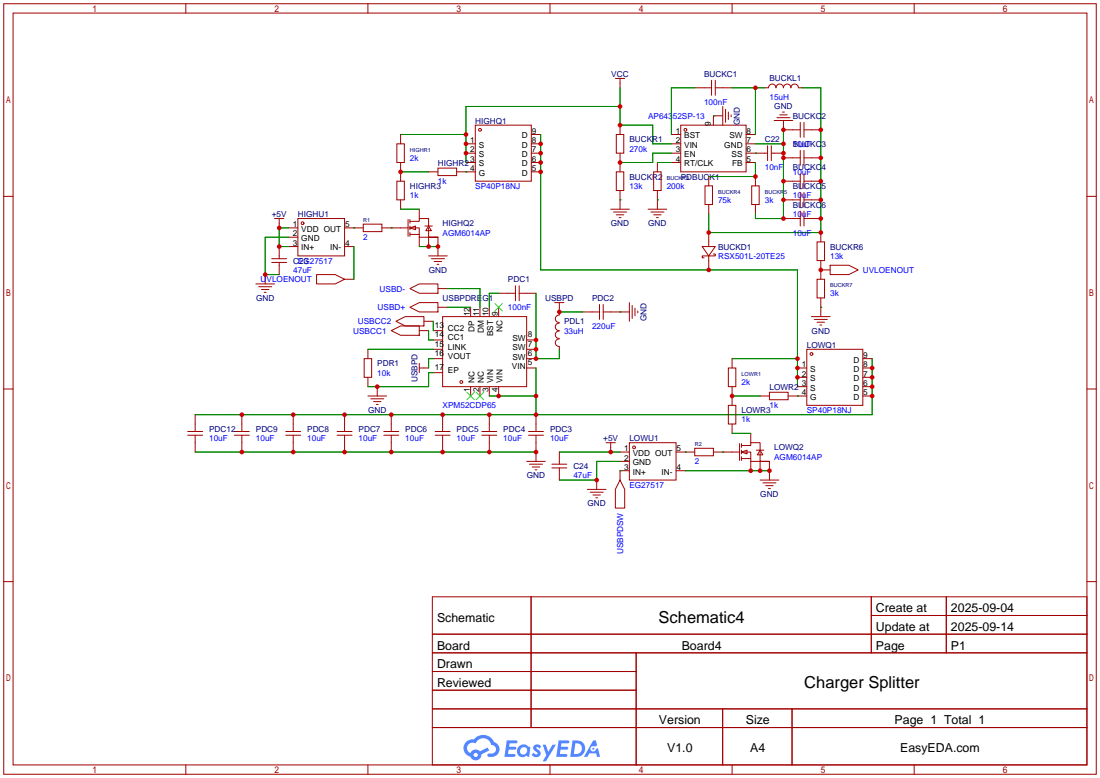
[picture p14: page 1]

Schematic | Schematic4 | Create at | 2025-09-04

Update at | 2025-09-14

Board | Board4 | Page | P1
Drawn | | Charger Splitter
Reviewed

Version | Size | Page 1 Total 1
V1.0 | A4 | EasyEDA.com
