dronebo1/lipo-charger-breakout-board/(list of files, drawings)

Other design files:
src/Charger Splitter.eprj
